hyperair/deltabob/BOM.ods

Deltabot BOM
Print material price (SGD/g) | 0.04
USD/SGD conversion | 1.34
 | Units | Vitamin bulk price | Vitamin bulk qty | Vitamin unit price (SGD) | Vitamin price (SGD) | Source | Printed weight | Printed price
Frame
2040 extrusions, 600mm | 3 |  |  |  | 0.00 | Adnan |  | 0
2040 extrusions, 300mm | 6 |  |  |  | 0.00 | Adnan |  | 0
Cutting service | 1 |  |  | 10.00 | 10.00 | Hiap Leong Metal Pte Ltd |  | 0
top-corner.scad | 3 |  |  |  | 0.00 | Printed | 276.36 | 33.1632
bottom-corner.scad | 3 |  |  |  | 0.00 | Printed | 266.64 | 31.9968
foot.scad | 6 |  |  |  |  | Printed | 13.38 | 3.2112
 |  |  |  |  | 0.00 |  |  | 0
Electronics |  |  |  |  | 0.00 |  |  | 0
Broken ATX PSU | 1 |  |  | 30.00 | 30.00 | Aaron
Sanguinololu | 1 |  |  | 0.00 | 0.00 | Adnan |  | 0
Raspberry PI 2 (Octoprint) | 1 |  |  | 30.00 | 30.00 | https://12geeks.com/shop/raspberry-pi-2-model-b-armv7-with-1g-ram.html |  | 0
NEMA17 | 4 |  |  | 21.00 | 84.00 | 12geeks |  | 0
NEMA17 gaskets | 3 | 11.06 | 5 | 2.21 | 6.63 | ebay |  | 0
SSR, 25A | 1 | 12.01 | 2 | 6.00 | 6.00 | http://www.aliexpress.com/item/-/1154754963.html |  | 0
 |  |  |  |  | 0.00 |  |  | 0
Heated build plate |  |  |  |  | 0.00 |  |  | 0
Silicone heater, 240mm | 1 |  |  | 44.21 | 44.21 | http://www.aliexpress.com/item/-/32315330605.html |  | 0
Glass, 240mmx3mm | 1 |  |  | 10.00 | 10.00 | Kwong Ling Frame Makers Pte Ltd |  | 0
Aluminium, 240mmx3mm | 1 |  |  | 21.40 | 21.40 | Hiap Leong Metal Pte Ltd |  | 0
Cork sheet | 1 |  |  | 2.00 | 2.00 | Daiso |  | 0
plate-mount.scad | 6 |  |  |  |  | Printed
 |  |  |  |  | 0.00 |  |  | 0
Carriage |  |  |  |  | 0.00 |  |  | 0
Shower rollers | 12 |  |  | S$2.14 | 25.73 | http://www.aliexpress.com/item/-/32244821236.html |  | 0
carriage.scad | 3 |  |  |  | 0.00 | Printed | 33.38 | 4.0056
eccentric-spacer.scad | 12 |  |  |  |  | Printed | 13.62 | 6.5376
 |  |  |  |  | 0.00 |  |  | 0
Linear motion |  |  |  |  | 0.00 |  |  | 0
GT2 pulley | 3 | 13.48 | 10 | 1.35 | 4.04 | http://www.aliexpress.com/item/-/1784098935.html |  | 0
GT2 belt (by meter) | 10 | 11.46 | 10 | 1.15 | 11.46 | http://www.aliexpress.com/item/-/1750196093.html
623zz bearings | 6 | 2.68 | 10 | 0.27 | 1.61 | http://www.aliexpress.com/item/-/1831174175.html |  | 0
 |  |  |  |  | 0.00 |  |  | 0
Hotend |  |  |  |  | 0.00 |  |  | 0
All-metal J-head | 1 |  |  | 9.25 | 9.25 | http://www.aliexpress.com/item/-/2041998945.html |  | 0
12V DC fan 4010 | 2 |  |  |  | 0.00 | Wye Mun |  | 0
 |  |  |  |  | 0.00 |  |  | 0
Rods |  |  |  |  | 0.00 |  |  | 0
Aluminium 9mm x 300mm rods | 1800 | 12.00 | 5000 | S$0.00 | 4.32 | Teck Cheong Aluminium Pte Ltd
u-joint.scad | 12 |  |  |  |  | Printed
 |  |  |  |  | 0.00 |  |  | 0
Effector |  |  |  |  | 0.00 |  |  | 0
platform.scad | 1 |  |  |  | 0.00 | Printed | 27.25 | 1.09
jhead-mount.scad | 1 |  |  |  | 0.00 | Printed |  | 0
 |  |  |  |  | 0.00 |  |  | 0
 |  |  |  |  | 0.00 |  |  | 0
 |  |  |  |  | 0.00 |  |  | 0
 |  |  |  |  | 0.00 |  |  | 0
 |  |  |  |  | 0.00 |  |  | 0
 |  |  |  |  | 0.00 |  |  | 0
 |  |  |  |  | 0.00 |  |  | 0
Grand total |  |  |  |  | 0.00 |  |  | 0 | 380.65032
 |  |  |  |  | 0.00 |  |  | 0
 |  |  |  |  | 0.00 |  |  | 0
 |  |  |  |  | 0.00 |  |  | 0
 |  |  |  |  | 0.00 |  |  | 0
 |  |  |  |  | 0.00 |  |  | 0
 |  |  |  |  | 0.00 |  |  | 0
 |  |  |  |  | 0.00 |  |  | 0
 |  |  |  |  | 0.00 |  |  | 0
 |  |  |  |  | 0.00 |  |  | 0
 |  |  |  |  | 0.00 |  |  | 0
 |  |  |  |  | 0.00 |  |  | 0
 |  |  |  |  | 0.00 |  |  | 0
 |  |  |  |  | 0.00 |  |  | 0
 |  |  |  |  | 0.00 |  |  | 0
 |  |  |  |  | 0.00 |  |  | 0
 |  |  |  |  | 0.00 |  |  | 0
 |  |  |  |  | 0.00 |  |  | 0
 |  |  |  |  | 0.00 |  |  | 0
 |  |  |  |  | 0.00 |  |  | 0
 |  |  |  |  | 0.00 |  |  | 0
 |  |  |  |  | 0.00 |  |  | 0
 |  |  |  |  | 0.00 |  |  | 0
 |  |  |  |  | 0.00 |  |  | 0
 |  |  |  |  | 0.00 |  |  | 0
 |  |  |  |  | 0.00 |  |  | 0
 |  |  |  |  | 0.00 |  |  | 0
 |  |  |  |  | 0.00 |  |  | 0
