hyperair/deltabob/effector.scad

use <MCAD/array/along_curve.scad>
use <MCAD/array/rectangular.scad>
use <MCAD/fasteners/nuts_and_bolts.scad>
use <MCAD/shapes/2Dshapes.scad>
use <MCAD/shapes/3Dshapes.scad>
include <MCAD/units/metric.scad>

include <configuration/delta.scad>
use <lib/delta.scad>
use <lib/effector.scad>
use <utils.scad>

$fs = 0.4;
$fa = 1;

module effector_place_hinge (opts)
{
    hinge_elevation = effector_get_hinge_elevation (opts);

    translate ([0, 0, hinge_elevation])
    rotate (-45, X)
    children ();
}

module effector_single_hinge (opts, mode = "full")
{
    hinge_d = effector_get_hinge_d (opts);
    wall_thickness = effector_get_wall_thickness (opts);
    hinge_elevation = effector_get_hinge_elevation (opts);

    hinge_od = hinge_d + wall_thickness * 2;

    module hinge_ball ()
    {
        sphere (d = hinge_d);
    }

    module hinge_peg ()
    {
        translate ([0, 0, -hinge_d * 0.1])
        mirror (Z)
        cylinder (d = hinge_od, h = 30);
    }

    effector_place_hinge (opts)
    if (mode == "full") {
        difference () {
            hinge_peg ();
            hinge_ball ();
        }
    } else if (mode == "peg") {
        hinge_peg ();
    } else if (mode == "ball") {
        hinge_ball ();
    }
}

module effector_hinge_pair (opts, mode = "full")
{
    hinge_spacing = effector_get_hinge_spacing (opts);

    translate ([-hinge_spacing / 2, 0])
    mcad_linear_multiply (
        no = 2, separation = hinge_spacing, axis = X)
    effector_single_hinge (opts, mode = mode);
}

module effector_place_hinge_pairs (opts)
{
    hinge_offset = effector_get_hinge_offset (opts);

    rotate (60, Z)
    mcad_rotate_multiply (no = 3, angle = 120)
    translate ([0, hinge_offset])
    children ();
}

module effector_all_hinges (opts, mode = "full")
{
    effector_place_hinge_pairs (opts)
    effector_hinge_pair (opts, mode = mode);
}

module effector_tether_block (opts)
{
    wall_thickness = effector_get_wall_thickness (opts);

    effector_place_hinge (opts)
    mirror (Z)
    cylinder (d = 2 + wall_thickness * 2, h = 100);
}

module effector_probe_ears (opts)
{
}

module effector_prongs (opts)
{
    prong_width = effector_get_prong_width (opts);
    cavity_d = effector_get_cavity_d (opts);
    prong_height = effector_get_prong_height (opts);

    mcad_rotate_multiply (no = 3, angle = 120)
    linear_extrude (height = prong_height)
    difference () {
        offset (r = 5)
        offset (r = -5)
        intersection () {
            translate ([-prong_width/2, 0])
            square ([prong_width, cavity_d + 10]);

            circle (d = cavity_d + 10 * 2);
        }

        circle (d = cavity_d);
    }
}

module effector_place_magnets (opts)
{
    magnet_offset = effector_get_magnet_offset (opts);

    rotate (60 + 15, Z)
    mcad_rotate_multiply (no = 3, angle = 120)
    translate ([0, magnet_offset, 0])
    children ();
}

module effector_magnet_holes (opts)
{
    magnet_d = effector_get_magnet_d (opts);
    magnet_h = effector_get_magnet_h (opts);
    magnet_ball_d = effector_get_magnet_ball_d (opts);
    thickness = effector_get_thickness (opts);

    effector_place_magnets (opts) {
        /* magnet holes */
        translate ([0, 0, thickness - thickness / 2])
        cylinder (d = magnet_d + 0.5, h = magnet_h);

        /* centering cones */
        ball_r = magnet_ball_d / 2;
        cone_depth = thickness / 2;
        ball_depth = cone_depth - 0.5;
        chord_z_offset = 1;

        chord_centre_distance = ball_r - ball_depth + chord_z_offset;
        half_chord_angle = acos ((chord_centre_distance) / ball_r);
        half_cone_angle = 90 - half_chord_angle;
        cone_angle = half_cone_angle * 2;
        half_chord_length = sqrt (pow (ball_r, 2) - pow (chord_centre_distance, 2));
        chord_length = half_chord_length * 2;

        cone_height_at_chord = half_chord_length / tan(half_cone_angle);
        d1 = (
            chord_length / cone_height_at_chord *
            (cone_height_at_chord + chord_z_offset)
        );
        d2 = (
            chord_length / cone_height_at_chord *
            (cone_height_at_chord + chord_z_offset - cone_depth)
        );
        echo (d1, d2, cone_depth, cone_angle, cone_height_at_chord);
        translate ([0, 0, -epsilon])
        cylinder (d1 = d1, d2 = d2, h = cone_depth);
    }
}

module effector_hotend_screwholes (opts)
{
    orbit_r = effector_get_prong_orbit_r (opts);
    prong_height = effector_get_prong_height (opts);
    thickness = effector_get_thickness (opts);
    nut_thickness = mcad_metric_nut_thickness (3);

    mcad_rotate_multiply (no = 3, angle = 120)
    mirror (Z)
    translate ([0, orbit_r])
    screwhole (
        size = 3,
        length = prong_height + thickness - nut_thickness,
        align_with = "above_nut"
    );
}

module effector_fan_mount (opts)
{
    thickness = 6;
    nut_thickness = mcad_metric_nut_thickness (3);
    hub_d = 12;
    width = hub_d * 2;

    module place_screw ()
    {
        translate ([hub_d / 2 + 2, 0])
        children ();
    }

    translate ([0, 0, -thickness / 2])
    difference () {
        union () {
            linear_extrude (height = thickness)
            hull () {
                translate ([0, -width / 2])
                square ([epsilon, width]);

                place_screw ()
                circle (d = hub_d);
            }

            /* nut trap */
            place_screw ()
            mirror (Z)
            rotate_extrude ()
            translate ([hub_d / 2 / 2, 0])
            trapezoid (
                bottom = hub_d / 2, top = hub_d / 2 - nut_thickness,
                height = nut_thickness,
                left_angle = 90
            );
        }

        place_screw ()
        translate ([0, 0, thickness])
        mirror (Z)
        screwhole (
            size = 3,
            length = thickness,
            align_with = "below_head"
        );

        /* center cutout */
        translate ([-epsilon, 0, thickness / 3])
        ccube (concat ([1, 1] * width * 2, [thickness / 3]), center = Y);
    }
}

module effector_place_fan (opts)
{
    cavity_d = effector_get_cavity_d (opts);

    mcad_rotate_multiply (no = 3)
    rotate (90, Z)
    translate ([cavity_d / 2 + 10, 0, 15])
    render () rotate (90, X)
    children ();
}

module effector (opts)
{
    thickness = effector_get_thickness (opts);
    cavity_d = effector_get_cavity_d (opts);

    render ()
    difference () {
        union () {
            /* basic solid shape */
            intersection () {
                hull ()
                effector_all_hinges (opts, mode = "peg");

                ccube ([1000, 1000, thickness], center = X + Y);
            }

            difference () {
                union () {
                    /* full hinge pegs */
                    effector_all_hinges (opts, mode = "peg");

                    /* tether block */
                    effector_place_hinge_pairs (opts)
                    effector_tether_block (opts);
                }

                mirror (Z)
                ccube ([1000, 1000, 100], center = X + Y);
            }

            effector_probe_ears (opts);
            effector_prongs (opts);

            effector_place_fan (opts)
            effector_fan_mount (opts);
        }

        /* center cavity */
        translate ([0, 0, -epsilon])
        cylinder (d = cavity_d, h = thickness + epsilon * 4);

        /* hinge balls */
        effector_all_hinges (opts, mode = "ball");

        /* tether holes */
        effector_place_hinge_pairs (opts)
        cylinder (d = 2, h = 30, center = true);

        /* hotend holes */
        effector_hotend_screwholes (opts);

        /* holes for magnet */
        effector_magnet_holes (opts);
    }
}

effector (delta_get_effector (deltabob));
