hyperair/deltabob/top-corner.scad

use <corner.scad>
use <lib/delta.scad>
include <configuration/delta.scad>


corner_top (delta_get_top_corner (deltabob));
