hyperair/deltabob/configuration/carriage.scad

carriage_extrusion_gap = 1;
carriage_thickness = 7;

carriage_belt_elevation = carriage_thickness + 1;
