hyperair/deltabob/configuration/fans.scad

use <../lib/fan.scad>

fan4010 = AxialFan (
    width = 40,
    thickness = 10,
    corner_radius = 3,
    screw_distance = 32
);
