hyperair/deltabob/configuration/resolution.scad

$fs = 0.4;
$fa = 1;
