hyperair/deltabob/(list of files, cad)

Other CAD files:
vitamins/e3dv5.scad
carriage-old.scad
groovemount-old.scad
