hyperair/deltabob/(commit log)

2015-03-09 Add tslotnut
    [tslotnut.scad]
2015-03-09 Add stl
2015-03-09 Add rostock jaws
    [jaws.scad]
2015-03-09 Add rostock joints
    [joint.scad]
2015-03-10 Rotate the nut hole
    Make it parallel to the tslot
    [tslotnut.scad]
2015-03-30 Add initial corner
    [corner.scad]
2015-03-30 Put extrusion screwholes
    [corner.scad]
2015-03-30 Cut out motor holes
    [corner.scad]
2015-03-31 Add clearance for vertical extrusion
    [corner.scad]
2015-03-31 Put vertical extrusions parallel to edge
    [corner.scad]
2015-03-31 Reduce clearance
    [corner.scad]
2015-03-31 Factor out motor placement bits
    [corner.scad]
2015-03-31 Beef up tslot_separation
    [corner.scad]
2015-03-31 Change base corner shape to save material
    [corner.scad]
2015-03-31 Don't hardcode tslot positions
    [corner.scad]
2015-04-01 Up the clearance
    [corner.scad]
2015-04-01 Move motor plate shape into base shape
    [corner.scad]
2015-04-01 Move horizontal tslot screws toward the obtuse side of corner
    This makes it easier for non-ball-headed allen keys to access them.
    [corner.scad]
2015-04-02 Finish up top corner
    [corner.scad]
2015-04-02 Render the rest of the frame and build plate
    [corner.scad]
2015-04-02 Move corner.scad to frame.scad and make separate files for top and bottom corner
    [bottom-corner.scad, frame.scad, top-corner.scad]
2015-04-15 Remove ! from top_corner() in frame.scad
    [frame.scad]
2015-04-15 Increase hextrusioN_length to 270
    [frame.scad]
2015-05-06 Factor out mirror_if() to utils.scad
    [frame.scad, utils.scad]
2015-05-06 Initial carriage
    [carriage.scad]
2015-05-09 Fix belt x offset
    [carriage.scad]
2015-05-09 Add initial parallel joints
    [carriage.scad]
2015-05-09 Raise the arms to proper position
    [carriage.scad]
2015-05-09 Factor out arm_thickness configurable
    [carriage.scad]
2015-05-09 Simplify rotate() call
    [carriage.scad]
2015-05-09 Move middle cutout deeper in to avoid obscuring the belt clamp
    [carriage.scad]
2015-05-09 Fix non-centered polyhole
    [carriage.scad]
2015-05-10 Fix missing include for utils.scad
    [utils.scad]
2015-05-10 Add carriage.scad to SCADFILES
2015-05-10 Bump up arm thickness
    [carriage.scad]
2015-05-10 Move arms and belt a away from each other
    [carriage.scad]
2015-05-10 Reduce belt clearance
    [carriage.scad]
2015-05-10 Chamfer opening of belt clamp, and add screw for tightening it
    [carriage.scad]
2015-05-17 Add eccentric spacer
2015-05-17 Bump eccentric spacer od in carriage
    [carriage.scad]
2015-05-17 Bump belt clearance back up to 0.1
    We now have a screw to tighten the clamp for avoiding backlash.
    [carriage.scad]
2015-05-17 Chamfer both sides of the belt clamp entrance
    [carriage.scad]
2015-05-17 Flip arms around so their supports face downwards
    [carriage.scad]
2015-05-17 Specify nuthole tolerance
    [carriage.scad]
2015-05-17 Move belt clamp to the bottom of the carriage
    [carriage.scad]
2015-05-17 Adjust tightening belt clamp tightening screw position
    [carriage.scad]
2015-05-17 Add BOM
    [BOM.ods]
2015-05-18 Add ecccentric spacer
    [eccentric-spacer.scad]
2015-05-18 Set m3 nut tolerance
    [carriage.scad]
2015-05-18 Factor out the m3 nut hole
    [carriage.scad]
2015-05-19 Add comment for eccentric spacer holes
    [carriage.scad]
2015-05-19 Reduce m3 nut tolerance
    The nuts keep falling out
    [carriage.scad]
2015-05-22 Begin making jaws more parametric
    [jaws.scad]
2015-05-22 Basic jaw shape
    [jaws.scad]
2015-05-22 Implement plug and bridge helper
    [jaws.scad]
2015-05-22 Fix bridge helper dimensions
    [jaws.scad]
2015-05-23 Tidy up parameters
    [jaws.scad]
2015-06-10 Add 2040 foot
    [foot.scad]
2015-06-14 Reduce h of jaw
    A 'h' too high reduces the degree of movement the u-joints have.
    [jaws.scad]
2015-06-14 Add crowned idler
    [crowned-idler.scad]
2015-06-14 Add bed holder
    [bedholder.scad]
2015-06-14 Add spacer for idler
    [idler-spacer.scad]
2015-06-15 Increase hole diameter for cap screw
    [bedholder.scad]
2015-06-15 Decouple thickness of bedholder under bolt from base thickness
    This allows us to use shorter screws.
    [bedholder.scad]
2015-06-20 Add groovemount.scad
    [groovemount.scad]
2015-06-21 Add groovemount top and bottom pieces to build system
    [groovemount-bottom.scad, groovemount-top.scad]
2015-06-21 Fix alignment of the slot in the jhead mount
    [groovemount.scad]
2015-06-21 Update BOM
    [BOM.ods]
2015-06-21 Add endstop.scad
    [endstop.scad]
2015-06-21 Add retractable probe
    [retractable.scad]
2015-06-21 Tweak retractable options and nut rotations
    [retractable.scad]
2015-06-21 Add struts to retractable piece for more rigidity
    [retractable.scad]
2015-06-24 Add pcb mount
    [pcb-mount.scad]
2015-06-24 Add echo for DELTA_SMOOTH_ROD_OFFSET in frame.scad
    This helps get us theoretical values for the delta frame to stick into Marlin.
    [frame.scad]
2015-06-25 Make mounting screwhole distance configurable in pcb mount
    [pcb-mount.scad]
2015-06-26 Add cable cover
    [cable-cover.scad]
2015-06-26 Refactor cable-cover to make more parametric
    [cable-cover.scad]
2015-06-26 Add cable-cover to Makefile
2015-06-29 Reduce nut tolerance in groove mount
    They keep falling out
    [groovemount.scad]
2015-06-29 Increase carriage base thickness and decrease wheel separation
    [carriage.scad]
2015-06-29 Make changes to foot.scad to allow for wires to be routed through the extrusions
    [foot.scad]
2015-07-01 Tweak joints for better fit
    [joint.scad]
2015-07-01 Decrease carriage base thickness a little
    [carriage.scad]
2015-07-01 Keep h as close to the original as possible for joint.scad
    More thickness = more stiffness. Hopefully.
    [joint.scad]
2015-07-02 Shrink polyholes back to 3mm for less backlash
    [joint.scad]
2015-07-03 Add pad-bushing as replacement wheels
    [pad-bushing.scad]
2015-07-03 Put reinforcement for rostock arms on both sides
    Stress relief
    [carriage.scad]
2015-07-03 Thicken belt clamp width
    [carriage.scad]
2015-07-03 Remove disabled buttress stiffener in carriage belt clamp
    [carriage.scad]
2015-07-03 Ditch mirror_if in favour of mcad_mirror_duplicate
    [carriage.scad]
2015-07-03 Move arms in carriage to the center to avoid impacting the washer areas
    [carriage.scad]
2015-07-03 Move belt clamp to the top of carriage in preparation for adding a second one
    [carriage.scad]
2015-07-05 Adjust retractable for 1.5mm allen key, and lower it relative to the platform
    [retractable.scad]
2015-07-05 Add some modules to utils.scad
    [utils.scad]
2015-07-06 Modify carriage for dual carriages
    [carriage.scad]
2015-07-06 Replace arm reinforcements with fillets
    [carriage.scad]
2015-07-06 Reindent cable-cover.scad and add fillets
    [cable-cover.scad]
2015-07-31 Add nut-trap version of groovemount
    [groovemount.scad]
2015-07-31 Add filleted_cylinder to utils
    [utils.scad]
2015-07-31 Restore original joint.scad hole faceting
    [joint.scad]
2015-07-31 Adjust wire hole relief in foot
    [foot.scad]
2015-07-31 Reduce grip_r in cable-cover
    [cable-cover.scad]
2015-07-31 Add groovemount-cap.scad
    [groovemount-cap.scad]
2015-07-31 Fix inverted clearance for nut
    [groovemount.scad]
2015-07-31 Chamfer thread entrance on cap
    [groovemount.scad]
2015-07-31 Adjust notches to be less painful on the fingers
    [groovemount.scad]
2015-07-31 Bump thread clearance up
    [groovemount.scad]
2015-08-01 Increase fillet_r for top_plate_cap
    [groovemount.scad]
2015-08-01 Raise m4 nut depth further
    [groovemount.scad]
2015-08-29 Add round() module into utils.scad
    [utils.scad]
2015-08-29 Add initial ball-effector.scad
    [ball-effector.scad]
2015-08-30 Simplify ball-effector shape
    [ball-effector.scad]
2015-10-05 Unhighlight the balls in ball-effector
    [ball-effector.scad]
2015-10-09 Add centered temporary probe for rostock effector
    [centered-probe.scad]
2015-10-10 Extend centered probe arm length
    [centered-probe.scad]
2015-10-10 Reduce probe foot thickness -- interferes with groovemount
    [centered-probe.scad]
2015-10-10 Offset microswitch to center its lever
    [centered-probe.scad]
2015-10-14 Remove ! from groovemount_cap
    [groovemount.scad]
2015-10-14 Reduce wall thickness on centered probe
    [centered-probe.scad]
2016-02-29 Add rod ball end
    [ball-end.scad]
2016-03-04 Add string hole
    [ball-effector.scad]
2016-03-04 Push hinges on effector out
    Avoid intersecting screwholes and string holes
    [ball-effector.scad]
2016-03-16 Update pcb-mount for new protoboard
    [pcb-mount.scad]
2016-03-20 Amend pcb-mount dimensions
    [pcb-mount.scad]
2016-03-20 Add e3dv5/6 drawing combo
    v5 sink, v6 heaterblock, v6 nozzle.
    [e3dv5.scad, utils.scad]
2016-03-27 Drop extraneous echo from stacked_cylinder()
    [utils.scad]
2016-03-27 Don't render e3dv5 in e3dv5.scad
    We need to include it
    [e3dv5.scad]
2016-06-27 Add initial ball-duct-effector
    [ball-duct-effector.scad]
2016-06-27 Add remake of corner (for more configurability)
    [carriage.scad, corner.scad, delta.scad, extrusions.scad, resolution.scad]
2016-06-27 Add handle to crank the bowden printed screw cap
    [top-plate-cap-handle.scad]
2016-06-27 Add prototype fan duct
    [fanduct.scad]
2016-07-04 Add slot_profile to AluminiumExtrusionProfile
2016-07-17 Update corner to use new Corner* structures
    [corner.scad, extrusions.scad]
2016-07-19 Finish up port of Corner to new config
    [corner.scad, delta.scad, extrusions.scad]
2016-07-21 Add slot interfaces
    [corner.scad]
2016-07-21 Fix mismatched corner arm length
    [corner.scad]
2016-07-24 Put screwholes on the corner blank
    [corner.scad, delta.scad]
2016-07-24 Add motor cutout for bottom corner
    [corner.scad, delta.scad]
2016-07-24 Make sure things work in when in v-radial mode
    [corner.scad]
2016-07-27 Reduce bottom_height to 100
    This matches the width of a typical power supply.
    [delta.scad]
2016-07-27 Complete utils.scad's filleted_cylinder
    It now has support for different top/bottom radii, as well as a chamfer
    radius.
    [utils.scad]
2016-07-27 Add tslot2020 profile
    [extrusions.scad]
2016-07-27 Add more screwholes for vertical aluex
    [delta.scad]
2016-07-27 Add δbob logo to corners
    [corner.scad]
2016-09-04 Add corner-top.scad and corner-bottom.scad
    [corner-bottom.scad, corner-top.scad]
2016-09-10 Move old carriage design to carriage-old.scad
    [carriage-old.scad]
2016-09-14 Add new carriage initial implementation
    [carriage.scad, delta.scad]
2016-09-15 Factor out gt2_belt module into its own file
    [carriage-old.scad, gt2.scad]
2016-09-18 Port carriage belt clamps from old version
    [carriage.scad, delta.scad]
2016-10-23 Implement carriage tether block
    [carriage.scad]
2016-11-06 Increase resolution of ball-effector
    [ball-effector.scad]
2016-11-19 Add screwhole module to utils
    [utils.scad]
2016-11-19 Handle screw_extra_length correctly in screwhole()
    [utils.scad]
2016-11-20 Add test e3dv5 mount
    [test-mount.scad]
2016-12-04 Add 3-prong effector-hotend mount
    [test-mount.scad, utils.scad]
2016-12-19 Add beginnings of effector to test-mount
    [test-mount.scad]
2017-02-20 Add effector config
    [delta.scad, effector.scad]
2017-05-02 effector: Add hotend prongs and probe magnet holes
    [delta.scad, effector.scad]
2017-05-02 Add hotend screwholes to effector
    [effector.scad]
2017-05-02 Increase size of centering holes underneath magnet
    [effector.scad]
2017-05-02 Fix missing ) in docstring
    [utils.scad]
2017-05-02 Adjust effector magnet centering hole size
    [effector.scad]
2017-05-02 Rename magnet_holes() module in effector.scad
    We need something less generic if we're going to include it into a full assembly
    scad later.
    [effector.scad]
2017-06-13 Add magnet holes to effector
    [effector.scad]
2017-06-18 Shrink the effector
    [delta.scad]
2017-07-02 Add effector fan mount
    [effector.scad]
2017-07-24 Add initial hotend configuration
    [delta.scad]
2017-08-24 Move groovemount to groovemount-old
    [groovemount-old.scad]
2017-08-27 Ensure cylinders in stacked_cylinder overlap
    [utils.scad]
2017-08-27 Add rounded_square to utils
    [utils.scad]
2017-08-27 Add initial groovemount port from test-mount
    [delta.scad, fans.scad, groovemount.scad]
2017-08-28 Port screw pillars to groovemount
    [groovemount.scad]
2017-08-29 Port air channel from test-mount.scad to groovemount.scad
    [groovemount.scad, utils.scad]
2017-08-30 Add fan screwholes and fan inset to groovemount
    [groovemount.scad]
2017-09-01 Add groovemount cap screwholes
    [delta.scad, groovemount.scad]
2017-09-17 Amend groove profile to incorporate some clearance
    [delta.scad]
2017-09-17 Add plated mode to groovemount.scad
    [groovemount.scad]
2017-10-11 Begin porting hotend cap onto groovemount.scad
    [delta.scad, groovemount.scad]
2017-10-15 Subtract hotend cap screwholes from hotend cap
    [groovemount.scad]
2017-10-15 Add effector mounting screwholes to the groovemount hotend cap
    [groovemount.scad]
2017-10-15 Add groovemount_hotend_cap to plated view of groovemount.scad
    [groovemount.scad]
2018-04-05 Add initial magnetic probe design
    [delta.scad, magnetic-probe.scad]
2018-04-15 Add microswitch struct
    [delta.scad, switch.scad]
2018-04-21 Finish up magnetic probe design
    [magnetic-probe.scad, switch.scad]
2018-04-25 Port {top,bottom}-corner.scad to new corner.scad
    [bottom-corner.scad, corner.scad, top-corner.scad]
2018-08-13 groovemount: Adjust prong direction for better fit
    We need some clearance for the fan, so arrange the prongs so that the fan is
    between them instead of facing a pillar.
    [groovemount.scad]
2018-08-13 e3dv5: Allow e3dv5 to be rendered into stl
    [e3dv5.scad]
2018-08-22 Move corner_top and corner_bottom bits into respective files
    [corner-bottom.scad, corner-top.scad, corner.scad]
2018-11-17 Add aluex clearance to corner pieces
    [corner.scad, delta.scad]
2019-03-01 Update jaws.scad to new MCAD folder structure
    [jaws.scad]
2020-07-08 Add initial assembly.scad
    [assembly.scad]
2020-07-08 Fix broken `use` statements
    MCAD has moved some symbols around
    [effector.scad, utils.scad]
2020-07-08 Make the glass plate actually look like glass
    [assembly.scad]
2020-07-09 Refactor v_profile orientation logic from assembly into lib/delta
    [assembly.scad]
2020-07-12 Add horizontal struts
    [assembly.scad, corner-top.scad, corner.scad]
2020-07-12 Add hack for openscad cgal assertion error
    Probably a rounding error from trying to difference a face that's almost at the
    same location as the positive object.
    [corner.scad]
2020-07-13 Move short_edge function into lib/delta.scad
    [assembly.scad]
2020-07-14 Refactor colour settings in assembly into a variable
    [assembly.scad]
2020-11-23 Tidy up cruft in carriage.scad
    [carriage.scad]
2021-06-20 Move e3dv5.{scad,stl} into vitamins folder
    [ball-duct-effector.scad, e3dv5.scad, test-mount.scad]
2021-06-20 Update import for mcad_linear_multiply
    [test-mount.scad]
2021-06-20 Fix broken imports of groovemount.scad
    [groovemount.scad]
2021-06-20 Add effector-assembly.scad
    [effector-assembly.scad]
2021-06-20 Add groovemount-assembly.stl makefile rule
2021-06-20 Fix weird rendering issue in groovemount preview
    [groovemount.scad]
2021-06-20 Fix weird rendering issue in effector
    [effector.scad]
2021-06-20 Unhardcode positioning of groovemount relative to effector
    [effector-assembly.scad]
2021-06-20 Bump effector prong height
    Raise the hotend until the fan can clear the effector plate
    [delta.scad]
2021-06-26 Move effector-assembly up so that nozzle is at [0, 0, 0]
    [effector-assembly.scad]
2021-06-26 Integrate effector assembly into main assembly
    [assembly.scad, delta.scad, effector-assembly.scad]
2021-07-08 Fix bitrot in magnetic-probe.scad after MCAD breaking changes
    [magnetic-probe.scad]
2021-08-11 Fix up bitrot in retractable.scad
    [retractable.scad]
2021-08-11 Drop retractable.scad, not relevant in v2
    [retractable.scad]
2021-08-11 Drop joint.scad
    Only relevant to v1
    [joint.scad]
2021-08-11 Drop crowned-idler
    Failed experiment, couldn't get it concentric enough to be useful
    [crowned-idler.scad]
2021-08-11 Update imports for ccube in bedholder.scad
    [bedholder.scad]
2022-05-21 Adjust delta_radius and print colour
    [delta.scad]
2022-05-21 Switch to vslot2040 for horizontal extrusions
    [delta.scad]
2022-05-21 Fix warning about undef in filleted_cylinder
    [utils.scad]
2022-05-30 Adjust frame height and colours
    [assembly.scad, effector-assembly.scad]
2022-09-28 Add power supply to assembly.scad
    [assembly.scad]
2022-09-28 Adjust dimensions for ball-end.scad
    [ball-end.scad]
2022-09-28 Begin work on orange pi3 + skr pico combined mount
    [opi-skrpico-mount.scad]
2022-10-16 Fix ccube import in pcb-mount.scad
    [pcb-mount.scad]
2022-10-20 Finish up opi-skrpico-mount with mounting arms
    [opi-skrpico-mount.scad]
2023-10-27 Drop render() call in groovemount.scad
    Doesn't actually render in nightly openscad
    [groovemount.scad]
2023-11-07 Increase carriage hinge elevation
    The tether needs clearance over the belt tensioner block for when the rods are
    nearly vertical
    [carriage.scad, delta.scad]
2023-11-09 Adjust dimensions of carriage
    Try to get clearance without raising hinge elevation too much.
    [carriage.scad, delta.scad]
2023-11-10 Optimize hinge_elevation on carriage
    [delta.scad]
2023-11-14 Begin fan mount
    [delta.scad, fan-mount.scad]
2023-11-15 Add print fan mount
    [delta.scad, fan-mount.scad]
2023-11-15 Drop obsolete scad files
    [groovemount-bottom.scad, groovemount-top.scad]
2023-11-16 Add print fan mount parameters into config object
    [delta.scad, fan-mount.scad]
2023-11-16 Integrate print fan mount into effector assembly
    [delta.scad, effector-assembly.scad, fan-mount.scad]
2023-11-18 Chonkify effector
    The effector is a bit flimsy, let's make it thicker to try to make it more rigid
    [delta.scad]
2023-11-18 Adjust probe magnetic mount
    [delta.scad, effector.scad]
2023-11-21 Adjust magnetic probe
    [magnetic-probe.scad, switch.scad]
2023-12-16 Increase effector prong height for hotend fan clearance
    [delta.scad]
2023-12-16 Fix up carriage-old.scad
    This is deprecated, but the gt2 belt clamp moving part hasn't been ported to the
    new carriage yet.
    [carriage-old.scad]
2024-01-26 Add dragonv6 hotend
    [delta.scad]
2024-01-26 Reduce *_extra_length default values in screwhole module
    This causes weird rendering glitches with both manifold and CGAL, probably due
    to rounding errors
    [utils.scad]
2024-01-26 Set default mode in groovemount to print
    Makefile compiles groovemount.stl without any defines, so this needs to be in
    print mode.
    [groovemount.scad]
2024-01-27 Tweak dragonv6 groovemount profile
    [delta.scad, groovemount.scad]
2024-02-20 Fix discrepancy between Delta and Effector hotend settings
    [delta.scad]
2024-02-20 Reduce effector size now that hotend is smaller
    [delta.scad]
2024-02-21 Clean up obsolete files and fix some old files
    [bottom-corner.scad, foot.scad]
2024-02-21 Tweak effector assembly
    [effector-assembly.scad]
2024-02-21 Add magnetic-probe.scad to Makefile, and sort SCADFILES
2024-02-22 Use different scaddeps filename for assembly
